elliotf/two-motor-extruder/plate.stl

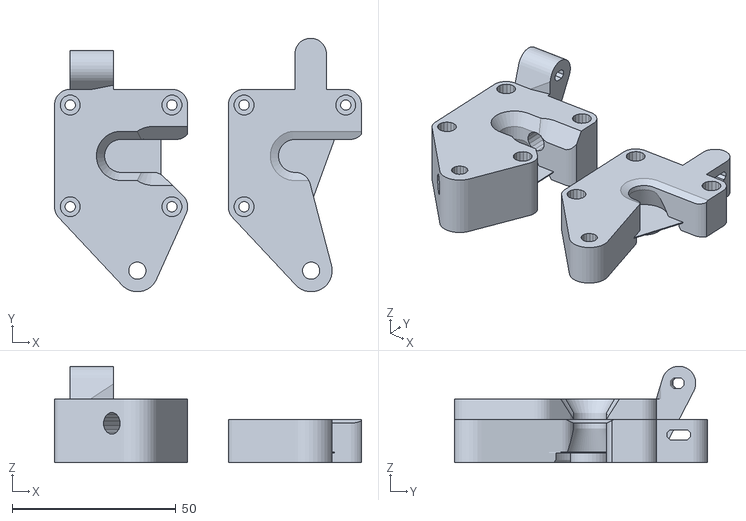
[picture p2: CAD file, 2015-05-28]
plate.stl
93.6 x 77.2 x 29.4
