elliotf/two-motor-extruder/config.scad

// All hail whosawhatsis
da6 = 1 / cos(180 / 6) / 2;
da8 = 1 / cos(180 / 8) / 2;

approx_pi = 3.14159;
resolution = 32;

// make coordinates more communicative
left  = -1;
right = 1;
front = -1;
rear  = 1;
top = 1;
bottom  = -1;

// address vector positions by their name
x = 0;
y = 1;
z = 2;

// Screws, nuts
m3_diam = 3.1;
m3_nut_diam  = 5.5;
m3_nut_thickness  = 3;
m3_socket_head_diam = 6;
m3_socket_head_height = 3;
m5_diam = 5;
m5_nut_diam = 8;
m5_nut_thickness = 5;
m5_bolt_head_thickness = 4;

// Motors
nema17_side = 43;
nema17_len = 36; // "half-length" nema 17
nema17_len = 48;
nema17_hole_spacing = 31;
nema17_screw_diam = m3_diam;
nema17_shaft_diam = 5;
nema17_shaft_len = 22.5 + 2;
nema17_short_shaft_len = 0;
nema17_shoulder_height = 2;
nema17_shoulder_diam = nema17_hole_spacing*.75;

nema14_side = 35.3;
nema14_len = 36;
nema14_hole_spacing = 26;
nema14_screw_diam = m3_diam;
nema14_shaft_diam = 5;
nema14_shaft_len = 20;
nema14_short_shaft_len = 20;
nema14_shoulder_height = 2;
nema14_shoulder_diam = 22;

motor_side = nema17_side;
motor_len = nema17_len;
motor_hole_spacing = nema17_hole_spacing;
motor_screw_diam = nema17_screw_diam;
motor_shaft_diam = nema17_shaft_diam;
motor_shaft_len = nema17_shaft_len;
motor_short_shaft_len = nema17_short_shaft_len;
motor_shoulder_height = nema17_shoulder_height;
motor_shoulder_diam = nema17_shoulder_diam;
motor_diam          = 51;

/*
motor_side = nema14_side;
motor_len = nema14_len;
motor_hole_spacing = nema14_hole_spacing;
motor_screw_diam = nema14_screw_diam;
motor_shaft_diam = nema14_shaft_diam;
motor_shaft_len = nema14_shaft_len;
motor_short_shaft_len = nema14_short_shaft_len;
motor_shoulder_height = nema14_shoulder_height;
motor_shoulder_diam = nema14_shoulder_diam;
*/

// Misc settings
extrusion_width = 0.5;
extrusion_height = 0.3;
min_material_thickness = extrusion_width*4;
spacer = 1;

// bearing size

// 4-40
idler_screw_diam = 3.2;
idler_screw_nut_diam = 6.8;
idler_screw_nut_thickness = 2.5;

// m3
idler_screw_diam = 3.2;
idler_screw_nut_diam = 5.7;
idler_screw_nut_thickness = 2.5;

// 608
bearing_height = 7;
bearing_outer  = 22;
bearing_inner  = 8;

// 626
bearing_height = 6;
bearing_outer  = 19;
bearing_inner  = 6;

// 625
bearing_height = 5.3;
bearing_outer  = 16;
bearing_inner  = 5;

// 608
idler_bearing_height = 7;
idler_bearing_outer  = 22;
idler_bearing_inner  = 8;

//626
idler_bearing_height = 6;
idler_bearing_outer  = 19;
idler_bearing_inner  = 6;

//625
idler_bearing_height = 5;
idler_bearing_outer  = 16;
idler_bearing_inner  = 5;

// use the same bearing as everywhere else
idler_bearing_height = bearing_height;
idler_bearing_outer  = bearing_outer;
idler_bearing_inner  = bearing_inner;

filament_diam = 3;
filament_hole_diam = filament_diam + 1;
bowden_tubing_diam = 6.5;
bowden_retainer_inner = 11;
bowden_retainer_body_diam = bowden_retainer_inner + 4;

mount_plate_thickness = 10;
bottom_thickness = m3_socket_head_diam + min_material_thickness;

ext_shaft_length  = 60;
hobbed_diam = 8;
hobbed_width = 7;
ext_shaft_diam = bearing_inner;
bearing_opening   = bearing_outer - 1;
ext_shaft_opening = hobbed_diam + 4;

carriage_hole_spacing = 30;
carriage_hole_small_diam    = m3_diam;
carriage_hole_large_diam    = 6;
carriage_hole_support_thickness = 8;

hotend_length = 63;
hotend_diam   = 16;
hotend_mount_hole_depth = 5;
hotend_mount_screw_hole_spacing = 24;
hotend_mount_screw_diam = 4;
hotend_mount_screw_nut = 7.3;
hotend_mount_length = 37.5*2;
hotend_mount_width = 28;
hotend_mount_height = 0;

hotend_height_above_groove   = 4.8;
hotend_groove_height         = 4.6;
hotend_groove_diam           = 12;
