elliotf/two-motor-extruder/two_motor.scad

include <config.scad>;
include <util.scad>;

/*

// ideas
printed circular bevel/dovetail so that the idler is prevented from falling out?
  idler would have a circular dovetail that sits in a negative space on the drive side (or vice versa)
  circular path with its origin at the hinge point

// TODO
bowden retainer void is too far in (hopefully fixed)
hobbed pulleys collide with extruder body when opening/closing (hopefully fixed)
motor hole mounts print horribly
hinge hole is too tight on an m5 bolt (gave it a bit more space, more resolution)

*/

// settings
hobbed_pulley_diam           = 9;
hobbed_pulley_effective_diam = 6.9;
hobbed_pulley_len            = 11;
hobbed_pulley_hob_diam       = 5;
hobbed_pulley_hob_to_base    = 8;
hobbed_area_opening          = hobbed_pulley_diam + 1;

bowden_tubing_diam        = 6.5;
bowden_retainer_inner     = 11;
bowden_retainer_body_diam = bowden_retainer_inner + 4;
filament_diam             = 3;
filament_opening_diam     = bowden_tubing_diam - 2;

resolution                   = 32;

extrusion_height = .3;
extrusion_width  = .6;

// positions

motor_x = motor_shaft_len/2 + motor_shoulder_height + 1;
motor_y = filament_diam/2 + hobbed_pulley_effective_diam/2;

motor_screw_head_opening = m3_nut_diam + 0.5;
rounded_diam           = motor_side - motor_hole_spacing;
rounded_diam           = motor_screw_head_opening + extrusion_width*6;
extruder_side          = motor_hole_spacing + rounded_diam;
motor_screw_length     = 10;
motor_screw_hole_depth = 3;
motor_mount_thickness  = motor_screw_length - motor_screw_hole_depth;

hinge_len            = motor_x;
hinge_gap            = 0.1;
hinge_diam           = 5;
hinge_nut_diam       = 8;
hinge_nut_outer_diam = 9;
hinge_opening_diam   = hinge_diam + hinge_gap*2;
hinge_body_diam      = max(hinge_opening_diam,hinge_nut_diam) + extrusion_width * 8;
hinge_pos_y          = front*(bowden_tubing_diam/2+extrusion_width*2+hinge_opening_diam/2);
hinge_pos_y          = 0;
hinge_pos_z          = -35;
hinge_offset         = bowden_retainer_body_diam/2;

drive_motor_x = (motor_x-hinge_offset/2) * right;
drive_motor_x = (hinge_offset) * right;
drive_motor_x = hobbed_pulley_hob_to_base + motor_shoulder_height + 2;
drive_motor_y = motor_y * rear;
drive_motor_z = 0;
idler_motor_x = (motor_x-2+hinge_offset) * left;
idler_motor_y = motor_y * front;
idler_motor_z = 0;

drive_side_height = abs(drive_motor_x) + hinge_offset;
idler_side_height = abs(idler_motor_x) - hinge_offset;

idler_nut_pos_x                 = left*(drive_side_height/2);
idler_nut_pos_x                 = left*(bowden_tubing_diam/2 + m3_diam/2 + 2);
idler_nut_pos_x                 = drive_motor_x-drive_side_height - m3_nut_diam/2 - 2;
idler_nut_pos_y                 = drive_motor_y+motor_hole_spacing/2;
idler_nut_pos_z                 = extruder_side/2 + 4 + m3_nut_diam/2;
idler_nut_angle_from_drive_side = 0;

idler_anchor_pos_x = 0;
idler_anchor_pos_x = 0;

show_drive_side = 1;
show_idler_side = 1;
show_bridges    = 1;
idler_assembly_angle     = 0;

module position_drive_motor() {
  translate([drive_motor_x,drive_motor_y,0]) {
    rotate([0,-90,0]) {
      children();
    }
  }
}

module cut_rounded_corner(diam,height=50) {
  translate([diam/2,diam/2,0]) {
    difference() {
      translate([-1,-1,0]) {
        cube([diam+1,diam+1,height],center=true);
      }
      hole(diam,height+1, resolution);
      translate([0,diam/2,0]) {
        cube([diam,diam,height+1],center=true);
      }
      translate([diam/2,0,0]) {
        cube([diam,diam,height+1],center=true);
      }
    }
  }
}

module position_idler_motor() {
  translate([idler_motor_x,idler_motor_y,0]) {
    rotate([0,90,0]) {
      children();
    }
  }
}

module base_body(main_height, hinge_pos_y, opening_side) {
  hole_dist = motor_hole_spacing/2;
  hull() {
    // main body
    for(d=[hole_dist]) {
      for(coords=[[0,d,-d],[0,-d,-d],[0,d,d],[0,-d,d]]) {
        translate(coords) {
          rotate([0,90,0]) {
            hole(rounded_diam,main_height,resolution);
          }
        }
      }
    }
    // hinge
    translate([0,hinge_pos_y,hinge_pos_z]) {
      rotate([0,90,0]) {
        hole(hinge_body_diam,main_height,resolution);
      }
    }
  }
}

module base_holes(main_height, hinge_pos_y, opening_side) {
  // motor shoulder
  rotate([0,90,0]) {
    hole(motor_shoulder_diam,(motor_shoulder_height+1)*2,resolution*2);
    //hole(hobbed_area_opening,(abs(drive_motor_x)-filament_diam/2)*2,resolution*2);
  }

  hull() {
    // clearance for drive-side grub screw
    rotate([0,90,0]) {
      hole(hobbed_area_opening,(abs(drive_motor_x)-filament_diam/2)*2,resolution*2);
      hole(hobbed_area_opening+6,(motor_shoulder_height+1)*2,resolution*2);
    }
  }

  // bevel the shoulder hole
  translate([-.5*opening_side,0]) {
    hull() {
      rotate([0,90,0]) {
        hole(motor_shoulder_diam+extrusion_width*2,1,resolution*2);
        hole(motor_shoulder_diam,1+extrusion_width*3,resolution*2);
      }
    }
  }

  // clearance for idler-side grub screw
  translate([opening_side*(main_height+1),0,0]) {
    hull() {
      rotate([0,90,0]) {
        hole(hobbed_area_opening+5,2,resolution);
        hole(hobbed_area_opening,main_height-hinge_offset/2+2-bowden_tubing_diam-extrusion_height*2,resolution);
      }
      translate([0,motor_side*opening_side,0]) {
        rotate([0,90,0]) {
          hole(hobbed_area_opening+5,2,resolution);
          hole(hobbed_area_opening,main_height-hinge_offset/2+2-bowden_tubing_diam-extrusion_height*2,resolution);
        }
      }
    }
  }

  // hobbed pulley area
  translate([opening_side*main_height/2,0,0]) {
    hull() {
      for(coords=[[0,0,0],[0,opening_side*motor_side/2,0]]) {
        translate(coords) {
          rotate([0,90,0]) {
            hole(hobbed_area_opening,main_height+1,resolution);
          }
        }
      }
    }

    // round the pulley area opening
    for(side=[top]) {
      translate([0,opening_side*motor_side/2,side*(hobbed_area_opening)/2]) {
        rotate([0,0,90+90*opening_side]) {
          rotate([0,90*-side,0]) {
            cut_rounded_corner(rounded_diam);
          }
        }
      }
    }
  }

  // motor screw holes
  for(y=[front,rear]) {
    for(z=[top,bottom]) {
      translate([main_height*opening_side,motor_hole_spacing/2*y,motor_hole_spacing/2*z]) {
        rotate([0,90,0]) {
          hole(m3_diam,motor_len*2,16);
          translate([0,0,10*opening_side]) {
            hole(motor_screw_head_opening,(main_height-motor_mount_thickness)*2+20,16);
          }
        }
      }
      translate([0,motor_hole_spacing/2*y,motor_hole_spacing/2*z]) {
        translate([-.5*opening_side,0,0]) {
          rotate([0,90,0]) {
            hull() {
              hole(m3_diam+extrusion_width*2,1,16);
              hole(m3_diam,1+extrusion_width*3,16);
            }
          }
        }
      }
    }
  }

  // hinge void
  translate([0,hinge_pos_y,hinge_pos_z]) {
    rotate([0,90,0]) {
      hole(hinge_opening_diam,main_height*2+1,16);
    }

    translate([-.5*opening_side,0,0]) {
      rotate([0,90,0]) {
        hull() {
          hole(hinge_opening_diam+extrusion_width*2,1,16);
          hole(hinge_opening_diam,1+extrusion_width*3,16);
        }
      }
    }
  }

  hinge_radius = -hobbed_area_opening/2-hinge_pos_z;
  /*
  % translate([0,hinge_pos_y,hinge_pos_z]) {
    rotate([0,90,0]) {
      hole(hinge_radius*2,4,resolution);
      hole(abs(hinge_pos_z)*2,1,resolution);
    }
  }
  */
}

module base_bridges(main_height, hinge_pos_y, opening_side) {
  translate([opening_side*(motor_shoulder_height+1+extrusion_height/2),0,0]) {
    rotate([0,90,0]) {
      cube([motor_shoulder_diam+1,motor_shoulder_diam+1,extrusion_height],center=true);
    }
  }
  translate([opening_side*(motor_shoulder_height+1)/2,0,0]) {
    rotate([0,90,0]) {
      hole(hobbed_area_opening+2,motor_shoulder_height+1,resolution);
    }
  }
}

module idler_screw_holes() {
  hull() {
    for(side=[0,bottom]) {
      rotate([-5*side,0,0]) {
        translate([0,0,0]) {
          rotate([90,0,0]) {
            translate([0,0,-rounded_diam/4+1-0.05]) {
              hole(m3_nut_diam+.1, rounded_diam/2+2, 6);
            }
          }
        }
      }
    }
  }
  hull() {
    for(side=[0,bottom]) {
      rotate([-5*side,0,0]) {
        translate([0,0,0]) {
          rotate([90,0,0]) {
            translate([0,0,motor_side]) {
              hole(m3_diam+.1, motor_side*2, 8);
            }
          }
        }
      }
    }
  }
}

module drive_side() {
  drive_hinge_pos_y = -drive_motor_y + hinge_pos_y;
  main_height       = drive_side_height;
  filament_pos_x    = -drive_motor_x;
  filament_pos_y    = -drive_motor_y;

  module pos_zero() {
    translate([-drive_motor_x,-drive_motor_y,0]) {
      children();
    }
  }

  module pos_idler() {
    pos_zero() {
      translate([idler_nut_pos_x,idler_nut_pos_y,idler_nut_pos_z]) {
        children();
      }
    }
  }

  module body() {
    idler_screw_body_len = motor_hole_spacing/2+motor_y-bowden_tubing_diam/2-4;

    translate([-main_height/2,0,0]) {
      translate([0,motor_hole_spacing/2-idler_screw_body_len/2,0]) {
        hull() {
          translate([-drive_motor_x+main_height/2+idler_nut_pos_x,0,idler_nut_pos_z]) {
            rotate([90,0,0]) {
              hole(m3_nut_diam+extrusion_width*8,idler_screw_body_len,resolution);
            }
          }
          translate([0,0,motor_hole_spacing/2+rounded_diam/2-0.05]) {
            cube([main_height,idler_screw_body_len,0.1],center=true);
          }
        }
        translate([0,0,extruder_side/2-rounded_diam]) {
          //cube([main_height,idler_screw_body_len,rounded_diam*2],center=true);
        }
      }
      intersection() {
        base_body(main_height, drive_hinge_pos_y, front);
        union() {
          translate([0,0,motor_side/2]) {
            cube([main_height*2,motor_side+1,motor_side],center=true);
          }
          hull() {
            translate([0,motor_side/2+hobbed_area_opening/2,-motor_side/2]) {
              cube([main_height*2,motor_side,motor_side],center=true);
            }
            translate([0,-motor_x/2-2,-hobbed_area_opening/2-rounded_diam/2]) {
              rotate([0,90,0]) {
                hole(rounded_diam,main_height+1,resolution);
              }
            }
            translate([0,drive_hinge_pos_y,hinge_pos_z]) {
              rotate([0,90,0]) {
                hole(hinge_body_diam,main_height+1,resolution);
              }
            }
            translate([0,-motor_hole_spacing/2,-motor_hole_spacing/2]) {
              rotate([0,90,0]) {
                hole(rounded_diam,main_height+1,resolution);
              }
            }
          }
        }
      }
    }
  }

  module bowden_retainer_void() {
    translate([0,0,10]) {
      hole(8,20);
    }

    hull() {
      translate([0,0,2]) {
        hole(bowden_retainer_inner,4);
      }
      translate([0,0,6]) {
        hole(8,2);
      }
    }
  }

  module holes() {
    base_holes(main_height, drive_hinge_pos_y, front);
    bowden_retainer_lip = extrusion_width*2;

    bottom_tubing_r = (motor_side*1.25)/2;
    angle_of_bottom_tubing_exit = 20;

    vertical_length = 5;

    // filament path
    translate([filament_pos_x,filament_pos_y,0]) {
      // bowden retainer holes
      translate([0,0,extruder_side/2-8]) {
        bowden_retainer_void();
      }

      // hotend-side bowden tubing path
      translate([0,0,motor_side/2]) {
        hole(bowden_tubing_diam,motor_side,16);
      }

      // for debugging the spool side bowden tube
      translate([-main_height/2,0,0]) {
        //cube([main_height,motor_side*2,motor_side*2],center=true);
      }

      translate([0,0,-hobbed_area_opening/2-vertical_length/2]) {
        hole(filament_opening_diam,vertical_length+0.05,16);
      }

      // spool side tubing
      translate([0,bottom_tubing_r,-hobbed_area_opening/2-vertical_length]) {
        intersection() {
          rotate([0,90,0]) {
            rotate_extrude($fn=resolution*3) {
              translate([bottom_tubing_r,0]) {
                accurate_circle(filament_opening_diam,16);
              }
            }
          }

          translate([0,-motor_side/2,-motor_side/2]) {
           cube([motor_side,motor_side,motor_side],center=true);
          }

          rotate([angle_of_bottom_tubing_exit,0,0]) {
            translate([0,-motor_side/2,motor_side/2]) {
             cube([motor_side,motor_side,motor_side+1],center=true);
            }
          }
        }

        rotate([angle_of_bottom_tubing_exit,0,0]) {
          translate([0,-bottom_tubing_r,-motor_side/2]) {
            hole(bowden_tubing_diam,motor_side,16);
          }
        }
      }
    }

    // idler side grub screw
    translate([front*(main_height+1),front*motor_y*2,0]) {
      hull() {
        rotate([0,90,0]) {
          hole(hobbed_area_opening+8,2,resolution);
          hole(hobbed_area_opening,main_height-hinge_offset/2+2-bowden_tubing_diam/2,resolution);
        }
        translate([0,motor_side*front,0]) {
          rotate([0,90,0]) {
            hole(hobbed_area_opening+8,2,resolution);
            hole(hobbed_area_opening,main_height-hinge_offset/2+2-bowden_tubing_diam/2,resolution);
          }
        }
      }
    }

    pos_idler() {
      idler_screw_holes();
    }

    // idler arc clearance
    idler_clearance_radius = sqrt(pow(-hinge_pos_z+motor_hole_spacing/2+rounded_diam/2,2)+pow(motor_hole_spacing/2+rounded_diam/2,2)) - 2;
    translate([-main_height-10,-drive_motor_y,hinge_pos_z]) {
      rotate([0,90,0]) {
        hole(idler_clearance_radius*2,20,resolution);
      }
    }
  }

  module bridges() {
    base_bridges(main_height, drive_hinge_pos_y, front);
  }

  difference() {
    body();
    holes();
  }
  if (show_bridges) {
    bridges();
  }
}

module idler_side() {
  idler_hinge_pos_y = -idler_motor_y + hinge_pos_y;
  main_height       = idler_side_height;

  module pos_zero() {
    translate([-idler_motor_x,-idler_motor_y,-idler_motor_z]) {
      children();
    }
  }

  module pos_idler() {
    pos_zero() {
      translate([idler_nut_pos_x,idler_nut_pos_y,idler_nut_pos_z]) {
        children();
      }
    }
  }

  module body() {
    translate([main_height/2,0,0]) {
      intersection() {
        base_body(main_height, idler_hinge_pos_y);
        union() {
          translate([0,0,motor_side/2]) {
            cube([main_height*2,motor_side,motor_side],center=true);
          }
          translate([0,-motor_side/2,0]) {
            cube([main_height*2,motor_side,motor_side],center=true);
          }
          hull() {
            translate([0,-motor_hole_spacing/2,-motor_hole_spacing/2]) {
              rotate([0,90,0]) {
                hole(rounded_diam,main_height+1,resolution);
              }
            }
            translate([0,0,-hobbed_area_opening/2-rounded_diam/2]) {
              rotate([0,90,0]) {
                hole(rounded_diam,main_height+1,resolution);
              }
            }
            translate([0,idler_hinge_pos_y,hinge_pos_z]) {
              rotate([0,90,0]) {
                hole(hinge_body_diam,main_height+1,resolution);
              }
            }
          }
        }
      }
    }

    idler_latch_width = abs(idler_motor_x) + idler_nut_pos_x + m3_diam/2 + extrusion_width*8;
    idler_latch_width = idler_side_height;
    hull() {
      translate([0,0,0]) {
        translate([idler_latch_width/2,rounded_diam/2,0]) {
          translate([0,0,idler_nut_pos_z+4]) {
            rotate([0,90,0]) {
              hole(rounded_diam,idler_latch_width,resolution);
            }
          }
          translate([0,0,0]) {
            rotate([0,90,0]) {
              hole(rounded_diam,idler_latch_width,resolution);
            }
          }
        }
      }
    }
  }

  module holes() {
    base_holes(main_height, idler_hinge_pos_y, rear);

    pos_idler() {
      hull() {
        for(side=[top,bottom]) {
          translate([0,0,2*side]) {
            rotate([90,0,0]) {
              hole(m3_diam,motor_side*3,8);
            }
          }
        }
      }
    }
  }

  module bridges() {
    opening_side = rear;
    translate([opening_side*(motor_shoulder_height+1+extrusion_height/2),0,0]) {
      rotate([20*-opening_side,0,0]) {
        rotate([0,90,0]) {
          translate([0,2*-opening_side,0]) {
            cube([motor_shoulder_diam+1,motor_shoulder_diam,extrusion_height],center=true);
          }
        }
      }
    }
    translate([opening_side*(motor_shoulder_height+1)/2,0,0]) {
      rotate([0,90,0]) {
        hole(hobbed_area_opening+2,motor_shoulder_height+1,resolution);
      }
    }
  }

  difference() {
    body();
    holes();
  }
  if (show_bridges) {
    bridges();
  }
}

module hobbed_pulley() {
  hob_rounded_radius = hobbed_pulley_effective_diam/2 + hobbed_pulley_hob_diam/2;

  difference() {
    translate([0,0,hobbed_pulley_len/2 - hobbed_pulley_hob_to_base]) {
      hole(hobbed_pulley_diam,hobbed_pulley_len,resolution);
    }

    rotate_extrude() {
      translate([hob_rounded_radius,0]) {
        circle(r=hobbed_pulley_hob_diam/2,$fn=resolution);
      }
    }
  }
}

module assembly() {
  // filament path
  % hole(filament_diam, motor_side*2, resolution);

  // idler screw
  % translate([idler_nut_pos_x,idler_nut_pos_y,idler_nut_pos_z]) {
    rotate([90,0,0]) {
      hole(m3_nut_diam, 3, 6);
      translate([0,0,15]) {
        hole(m3_diam, 30, resolution);
      }
    }
  }

  if (show_drive_side) {
    translate([drive_motor_x+0.05,drive_motor_y,drive_motor_z]) {
      color("orange") drive_side();
    }

    translate([0.05,0,0]) {
      position_drive_motor() {
        if (show_motors) {
          % motor();
        }

        translate([0,0,drive_motor_x]) {
          % color("silver") hobbed_pulley();
        }
      }
    }
  }

  if (show_idler_side) {
    translate([idler_motor_x-0.05,0,hinge_pos_z]) {
      rotate([idler_assembly_angle,0,0]) {
        translate([0,idler_motor_y,-hinge_pos_z]) {
          color("lightblue") idler_side();
        }
      }
    }
    translate([-0.05,0,0]) {
      position_idler_motor() {
        if (show_motors) {
          % motor();
        }

        translate([0,0,-idler_motor_x]) {
          % color("silver") hobbed_pulley();
        }
      }
    }
  }
}

module plate() {
  min_dist_between_parts = 5;
  translate([-motor_side/2-min_dist_between_parts,0,0]) {
    rotate([0,0,90]) {
      rotate([0,90,0]) {
        drive_side();
      }
    }
  }
  translate([motor_side/2+min_dist_between_parts,0,0]) {
    rotate([0,0,-90]) {
      rotate([0,-90,0]) {
        idler_side();
      }
    }
  }
}

//assembly();
plate();
