elliotf/two-motor-extruder/(list of files, cad)

Other CAD files:
assembly.scad
main.scad
plate.scad
