elliotf/two-motor-extruder/(commit log)

2013-08-16 First commit, good progress.
    [assembly.scad, assembly.stl, gear_plate.scad, gears.scad, nema.scad, parametric_involute_gear_v5.0.scad, spur_generator.scad]
2013-08-16 Motor, hotend mounting screw holes
    [assembly.scad]
2013-08-16 Updated STL separately
    [assembly.stl]
2013-08-17 Idler progress
    [assembly.scad]
2013-08-17 Updated STLs with output from last commit
    [assembly.stl]
2013-08-17 Remove incorrect copyright/license
    Left over from when I started modifying the gears in his script
    [assembly.scad]
2013-08-17 First pass at idler, material saving
    [assembly.scad]
2013-08-17 Update STLs with output from last commit
    [assembly.stl]
2013-08-17 Improve printability by reducing acute angles
    [assembly.scad]
2013-08-17 Force correct bridging in slic3r
    The bridge gap should probably make the lone bridge width a clean
    multiple of extrusion width.
    [assembly.scad]
2013-08-17 Lessons learned from a printing
    [assembly.scad]
2013-08-17 Let idler screws go all the way through if necessary
    [assembly.scad]
2013-08-17 larger holes for nuts, screws, bearings
    [assembly.scad]
2013-08-17 Bigger holes for carriage mounting holes
    [assembly.scad]
2013-08-17 More material saving fun
    [assembly.scad]
2013-08-17 Larger holes, material saving fun
    [assembly.scad]
2013-08-17 Notes, more material saving
    [assembly.scad]
2013-08-18 Fix bridging again
    [assembly.scad]
2013-08-18 Move to 626 bearings since my 625 bearings are crap
    [assembly.scad, assembly.stl]
2013-08-19 Move calculations to variables to be reused
    [assembly.scad]
2013-08-19 Snapshot of current work
    [assembly.stl]
2013-08-23 Tweaks to material saving, bridging, idler screw, filament position
    [assembly.scad]
2013-08-23 File reorganization
    [gear_plate.scad, main.scad]
2013-08-23 STL output from Makefile
    [gear_plate.stl]
2013-08-23 Makefile target for the extruder body and idler
    [main_plate.scad]
2013-08-23 STL output from make
    [gear_plate.stl, main_plate.stl]
2013-08-23 Remove fiddly corner by gear bearing
    [main.scad]
2013-08-23 Reduce magic numbers, make code more clear
    [main.scad]
2013-08-23 Updated STL output
    [gear_plate.stl, main_plate.stl]
2013-08-24 Progress on idler, move to 4-40 idler screws
    [main.scad]
2013-08-24 idler has holes, comment out for now
    [main_plate.scad]
2013-08-24 Printing STLs
    [gear_plate.stl, main_plate.stl]
2013-08-26 Did not hob M6 threaded rod very well, try brass hobb
    [main.scad]
2013-08-26 Bridge hint not necessary with tiny flat at the opening
    [main.scad]
2013-08-26 Hole in idler fixed
    [main_plate.scad]
2013-08-27 Migrate to M5 shaft with hobbed gear
    [main.scad]
2013-08-27 Make smaller gear more printable, add M5 shaft size
    [gear_plate.scad, gears.scad]
2013-08-27 STLs updated with changes
    [gear_plate.stl, main_plate.stl]
2013-08-27 Generate an assembled view STL
    [assembly.scad, main.scad]
2013-08-27 STL view of assembled extruder
    [assembly.stl]
2013-08-27 Updated STLs
    [gear_plate.stl, main_plate.stl]
2013-10-08 Make idler not hover above build plate
    [main_plate.scad]
2013-10-08 Updated build plate
    [main_plate.stl]
2013-10-29 Clean up root dir
    [assembly.scad, assembly.stl, gear_plate.scad, gear_plate.stl, gears.scad, main.scad, main_plate.scad, main_plate.stl]
2013-10-29 Simplify before making changes
    [main.scad]
2013-10-30 Attempting simplification, more parameterization
    [base.scad, config.scad, gears.scad, main.scad, positions.scad, util.scad]
2013-10-30 Simpler design, handle nema17 motor better
    Also, move extruder shaft closer to hotend to reduce the amount of
    distance filament has to travel inside the extruder
    [base.scad, main.scad, positions.scad]
2013-10-30 Make sure bridges reach each edge
    [main.scad]
2013-10-30 Groove for idler
    [gears.scad, main.scad]
2013-10-31 Material savings
    [main.scad]
2013-10-31 Avoid odd crevice; align things better
    [base.scad, main.scad, positions.scad]
2013-10-31 Make slic3r happier by removing a hole
    [main.scad, positions.scad]
2013-10-31 I'll probably use a full-length nema17 at first
    [base.scad]
2013-10-31 Updated STLs for new version of nema14
    [assembly.stl, gear_plate.stl, main_plate.stl]
2013-10-31 Whoops, was rendering the Nema17 version
    [base.scad]
2013-10-31 SRSLY, the new version of the nema14 version
    [assembly.stl, gear_plate.stl, main_plate.stl]
2013-11-03 Trying out NEMA17
    [base.scad, gears.scad, main.scad]
2013-11-03 NEMA17 version
    [assembly.stl, gear_plate.stl, main_plate.stl]
2013-11-03 Fidding with NEMA17 gear ratio
    [gears.scad, main.scad]
2015-05-03 Commit of WIP
    [rewrite_simpler.scad]
2015-05-03 More WIP
    [base.scad, gears.scad, positions.scad, rewrite_simpler.scad, util.scad]
2015-05-05 As printed
    [base.scad, gears.scad, positions.scad, rewrite_simpler.scad]
2015-05-05 As printed (STL render)
    [rewrite_simpler.stl]
2015-05-07 Non-full-depth idler arm WIP
    [gears.scad, positions.scad, rewrite_simpler.scad]
2015-05-10 More room for idler bearing, etc.
    [base.scad, positions.scad, rewrite_simpler.scad]
2015-05-10 Render of extruder
    [rewrite_simpler.stl]
2015-05-10 Remove tidbit of material
    [rewrite_simpler.scad]
2015-05-10 Another rendering
    [rewrite_simpler.stl]
2015-05-21 WIP before switch to bolt for hinge
    [base.scad, rewrite_simpler.scad, two_motor.scad]
2015-05-22 Beginnings of basic drive/idler sides
    [two_motor.scad]
2015-05-22 First pass at main extruder bodies
    [base.scad, two_motor.scad]
2015-05-22 Bridges for motor shoulder
    [two_motor.scad]
2015-05-22 Improve printability, parametricity
    [two_motor.scad]
2015-05-23 As is being printed now
    [base.scad, two_motor.scad]
2015-05-23 Rendering that is being printed at the moment
    [two_motor.stl]
2015-05-23 Attempt to address issues found in print
    [two_motor.scad]
2015-05-23 Rendering of file with changes
    [two_motor.stl]
2015-05-25 Pivot inline with the filament
    Clearance for grub screws, too.
    [two_motor.scad, util.scad]
2015-05-25 Rendering with changes
    [two_motor.stl]
2015-05-25 Room for grub screws, allow shorter motor shaft
    [two_motor.scad]
2015-05-25 Rendering of changes
    [two_motor.stl]
2015-05-28 More room for grub screws
    [two_motor.scad]
2015-05-28 Rendering with more grub screw room
    [two_motor.stl]
2015-05-28 First take on an idler screw
    [two_motor.scad]
2015-05-28 Rendered with the first take of idler arm
    [two_motor.stl]
2015-05-28 Shorter idler screw length
    [two_motor.scad]
2015-05-28 Rendering with new idler
    [two_motor.stl]
2015-05-28 More functional spool-side filament direction
    [two_motor.scad]
2015-05-28 Rendered with new spool-side
    [two_motor.stl]
2015-05-28 Less wobble in the idler screw
    [two_motor.scad]
2015-05-28 SRSLY, done for now
    [two_motor.stl]
2015-05-29 Cleaning up old files
    [assembly.scad, assembly.stl, config.scad, gear_plate.scad, gear_plate.stl, gears.scad, main.scad, main_plate.scad]
2015-05-29 More cleanup of files
    [main.scad]
2015-05-29 Motor looks like a kysan now
    Even though the 400-step motor I have doesn't look like this...
    [config.scad, util.scad]
2015-05-29 Extract display from design file
    [assembly.scad, main.scad, plate.scad]
